maxeo/3dprint-supporto-telefono/originale/foto_5.jpg

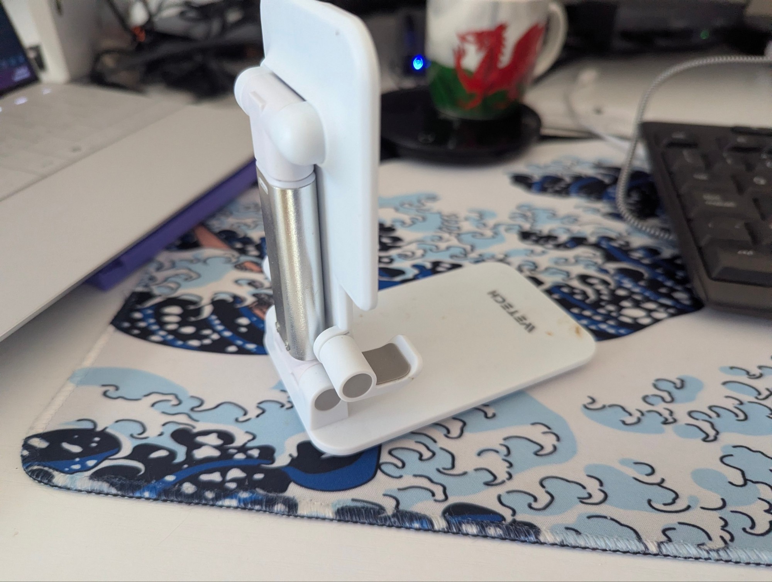
originale/foto_5.jpg
