maxeo/3dprint-supporto-telefono/originale/foto_2.jpg

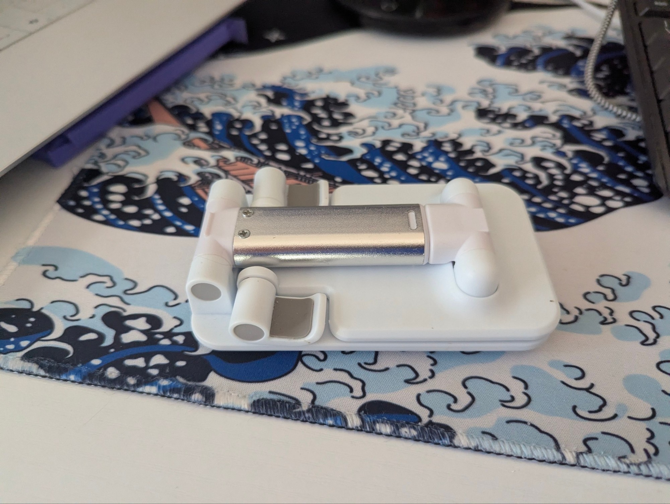
originale/foto_2.jpg
