maxeo/3dprint-supporto-telefono/blender/homescreen.webp

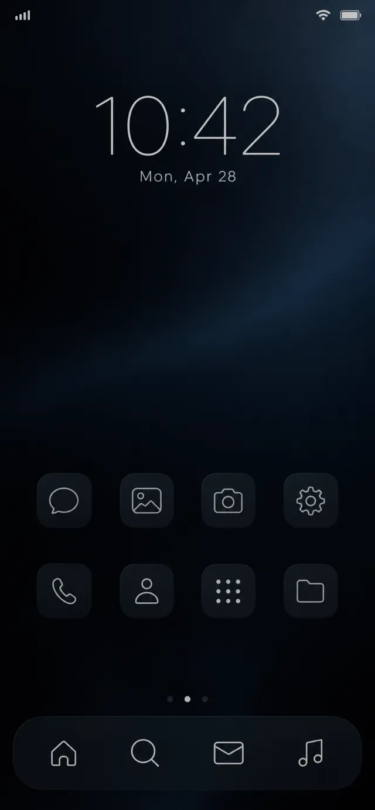
blender/homescreen.webp
