maxeo/3dprint-supporto-telefono/originale/foto_1.jpg

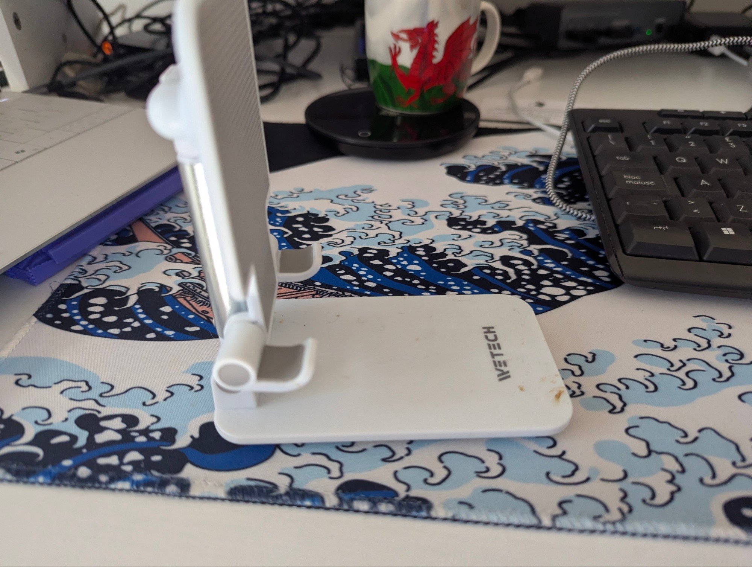
originale/foto_1.jpg
