maxeo/3dprint-supporto-telefono/originale/foto_3.jpg

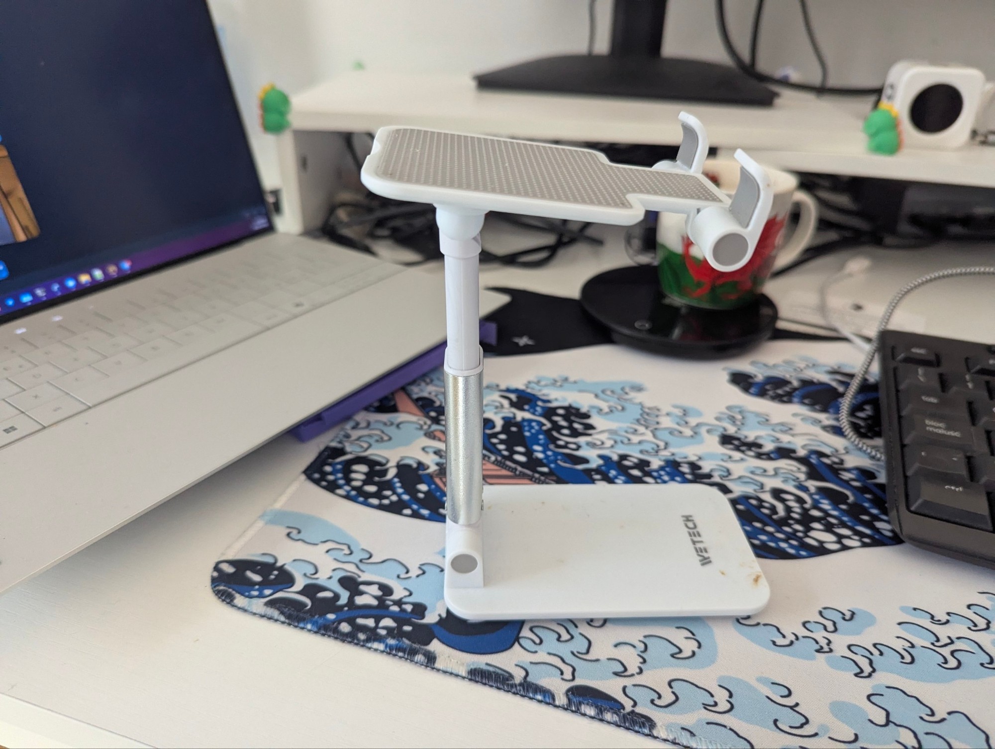
originale/foto_3.jpg
