maxeo/3dprint-supporto-telefono/originale/foto_4.jpg

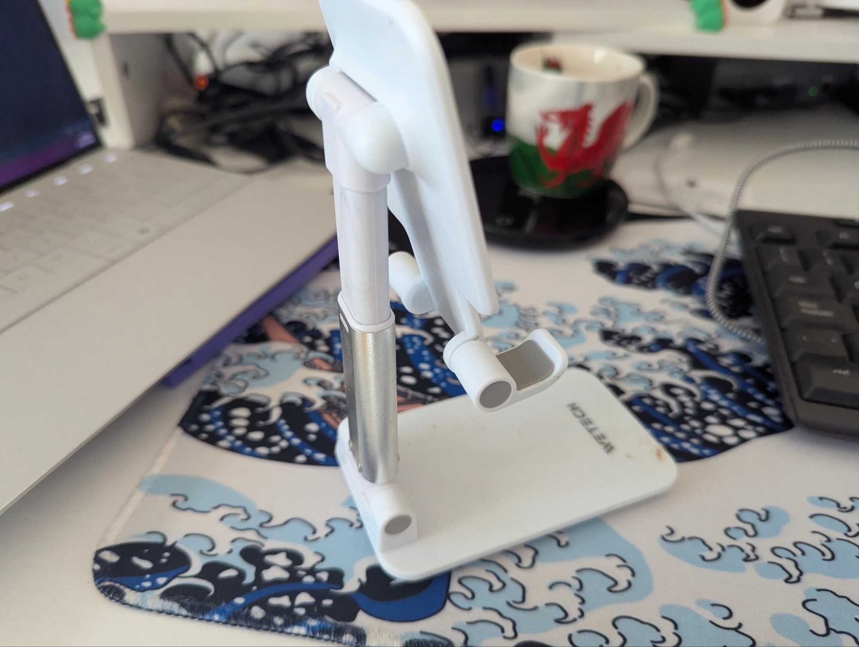
originale/foto_4.jpg
