maxeo/3dprint-supporto-telefono/originale/foto_6.jpg

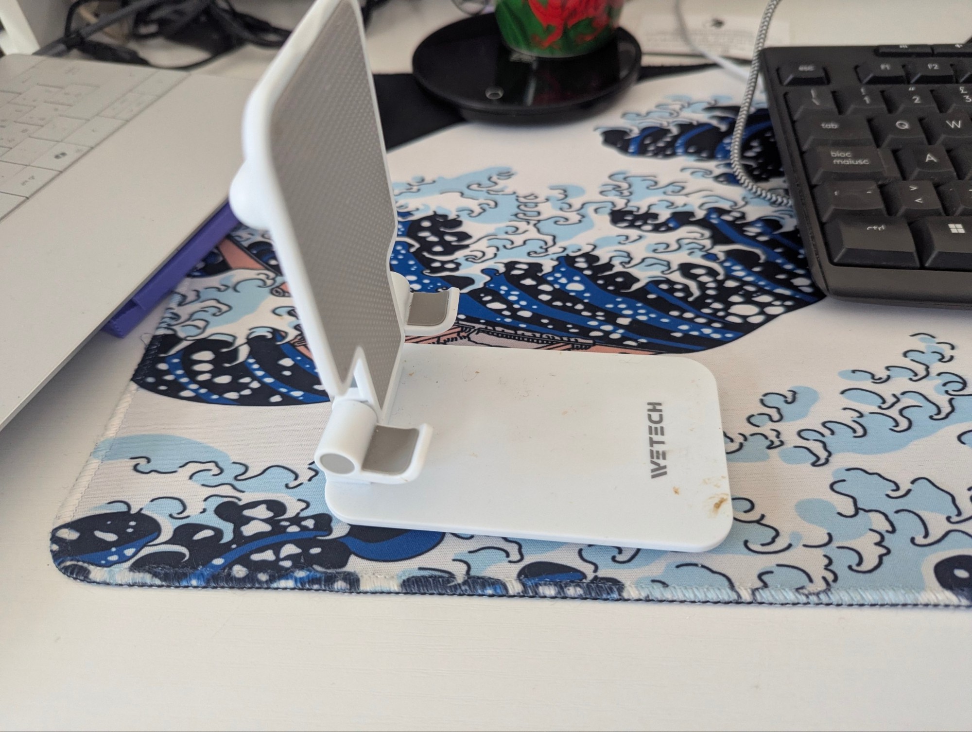
originale/foto_6.jpg
