maxeo/3dprint-supporto-telefono/stl/P05_Appoggio.stl

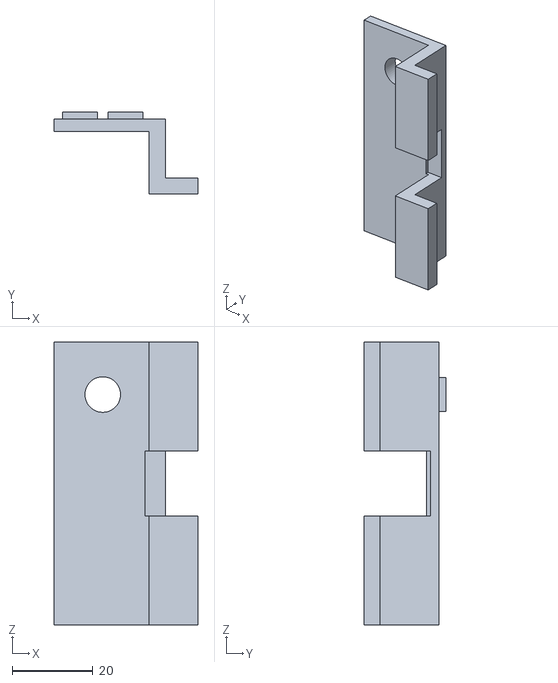
[picture p8: CAD file, 2026-11-01]
stl/P05_Appoggio.stl
35.5 x 20.3 x 70.0
