maxeo/3dprint-supporto-telefono/stl/prove/P10_Pomello_Appoggio_Passante.stl

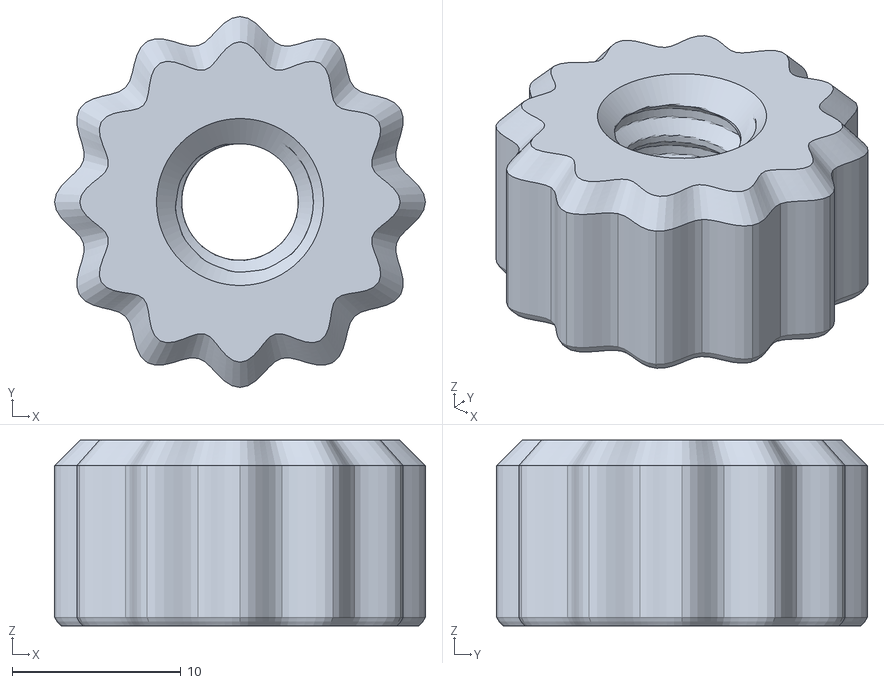
[picture p9: CAD file, 2026-11-01]
stl/prove/P10_Pomello_Appoggio_Passante.stl
22.0 x 22.0 x 11.0
