maxeo/3dprint-supporto-telefono/stl/P02_Guaina.stl

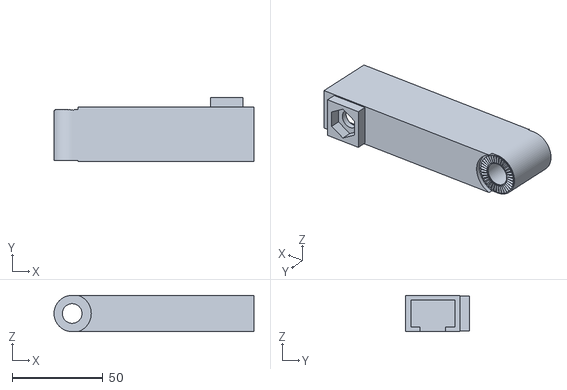
[picture p10: CAD file, 2026-11-01]
stl/P02_Guaina.stl
110.0 x 35.0 x 20.0
