maxeo/3dprint-supporto-telefono/stl/P14_Rondella_Dentata.stl

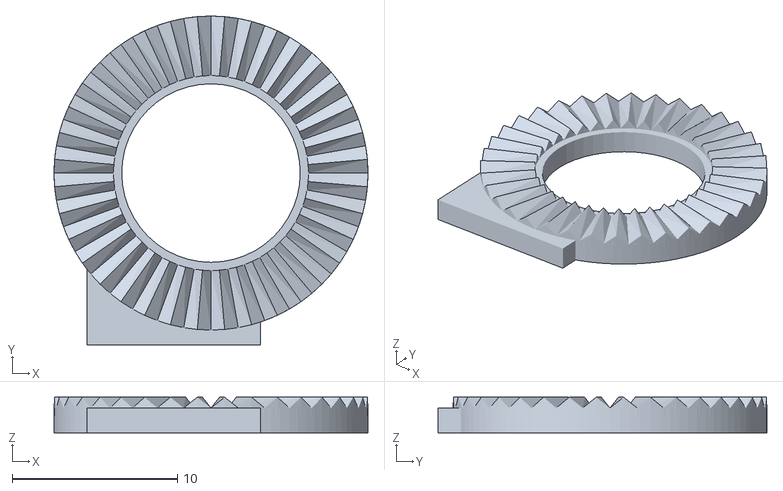
[picture p11: CAD file, 2026-11-01]
stl/P14_Rondella_Dentata.stl
19.0 x 19.9 x 2.15
