maxeo/3dprint-supporto-telefono/stl/P13_Galletto.stl

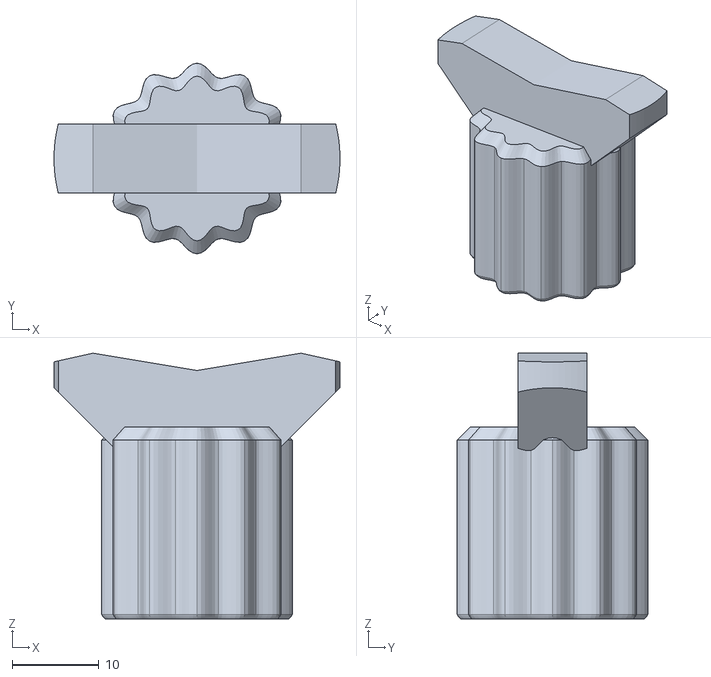
[picture p12: CAD file, 2026-11-01]
stl/P13_Galletto.stl
33.0 x 22.0 x 30.6
