maxeo/3dprint-supporto-telefono/stl/P10_Pomello_Appoggio.stl

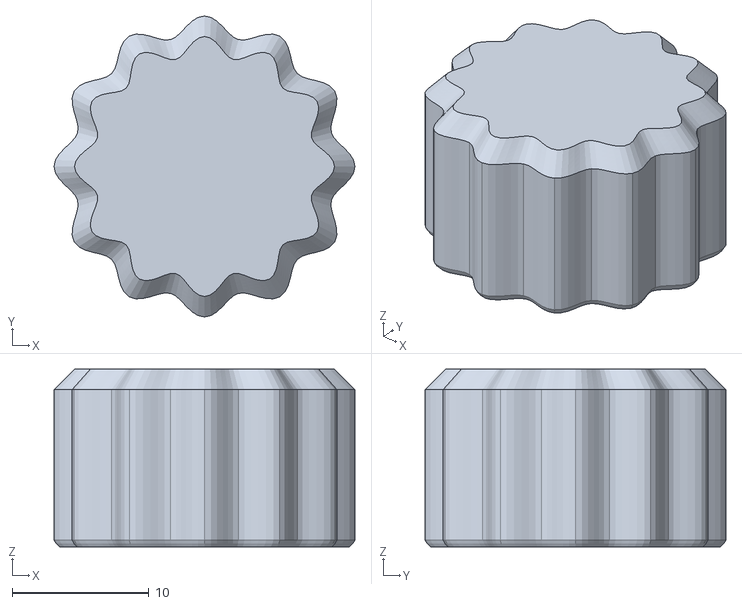
[picture p13: CAD file, 2026-11-01]
stl/P10_Pomello_Appoggio.stl
22.0 x 22.0 x 13.0
