maxeo/3dprint-supporto-telefono/stl/P06_Pomello.stl

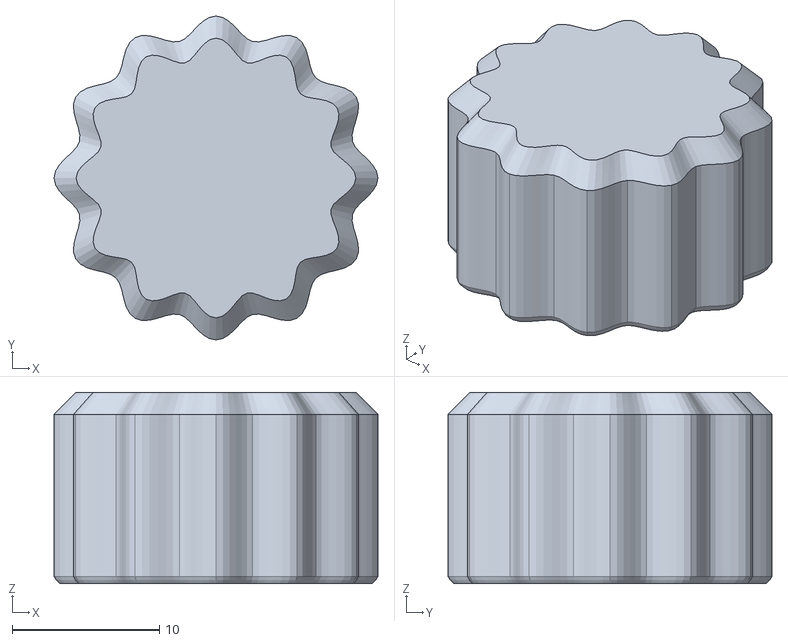
[picture p14: CAD file, 2026-11-01]
stl/P06_Pomello.stl
22.0 x 22.0 x 13.0
