maxeo/3dprint-supporto-telefono/stl/P04_Piatto.stl

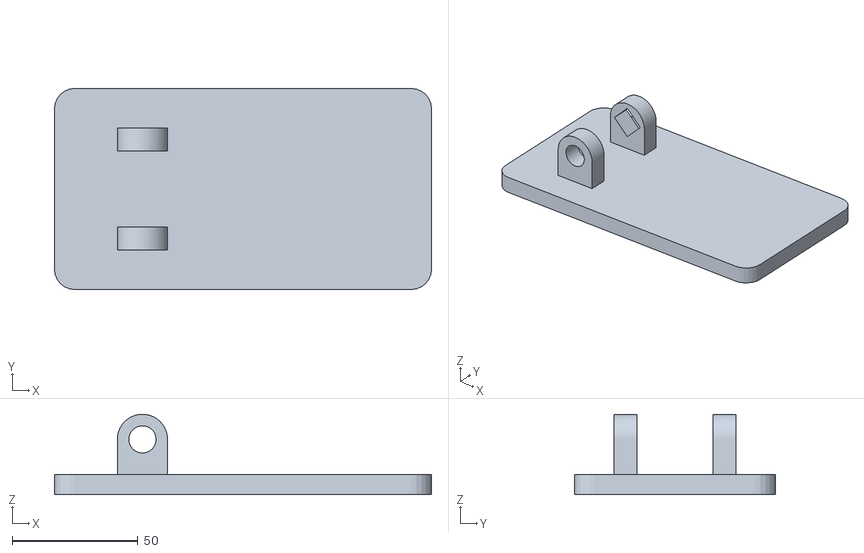
[picture p15: CAD file, 2026-10-31]
stl/P04_Piatto.stl
150.0 x 80.0 x 32.0
