maxeo/3dprint-supporto-telefono/stl/P12_Dado_Morsa.stl

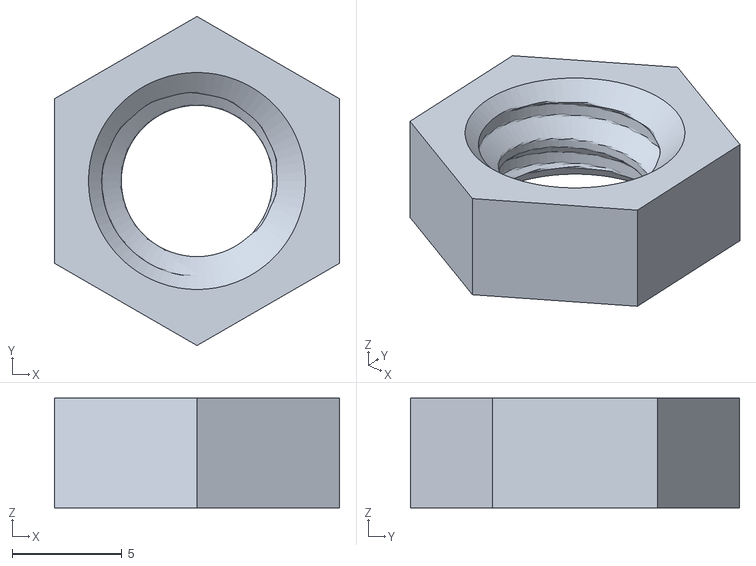
[picture p16: CAD file, 2026-10-31]
stl/P12_Dado_Morsa.stl
13.0 x 15.0 x 5.00
