maxeo/3dprint-supporto-telefono/stl/P03_Slitta.stl

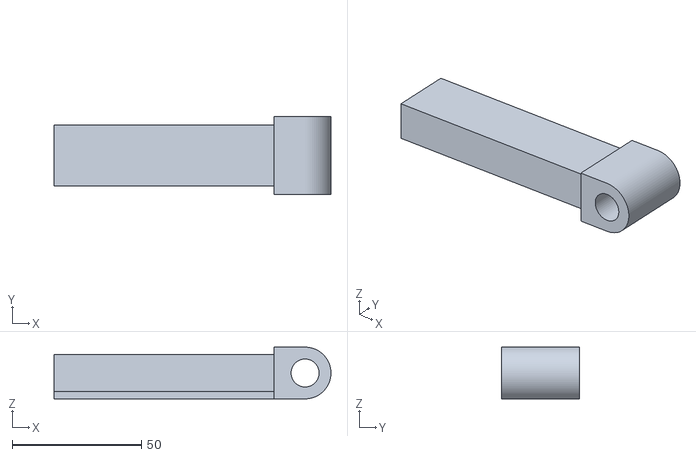
[picture p17: CAD file, 2026-10-31]
stl/P03_Slitta.stl
107.0 x 30.0 x 20.0
