maxeo/3dprint-supporto-telefono/stl/P08_Vite_Cerniera.stl

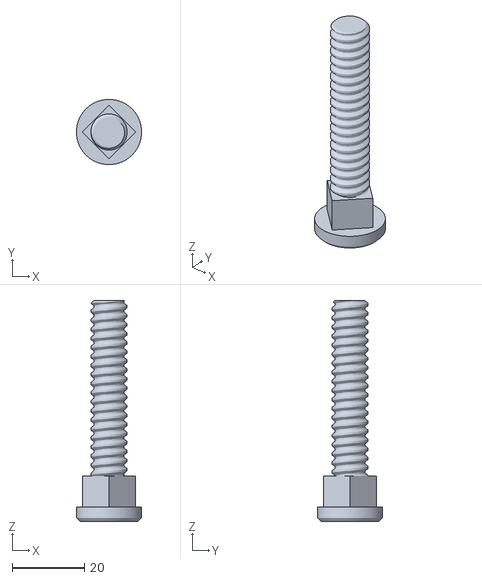
[picture p18: CAD file, 2026-10-31]
stl/P08_Vite_Cerniera.stl
18.0 x 18.0 x 61.0
