maxeo/3dprint-supporto-telefono/stl/P07_Prolunga.stl

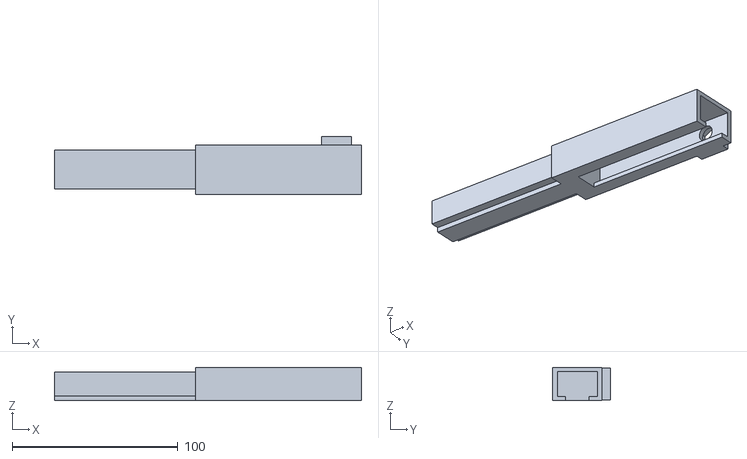
[picture p19: CAD file, 2026-10-31]
stl/P07_Prolunga.stl
185.0 x 35.0 x 20.0
