maxeo/3dprint-supporto-telefono/stl/P09_Vite_Appoggio.stl

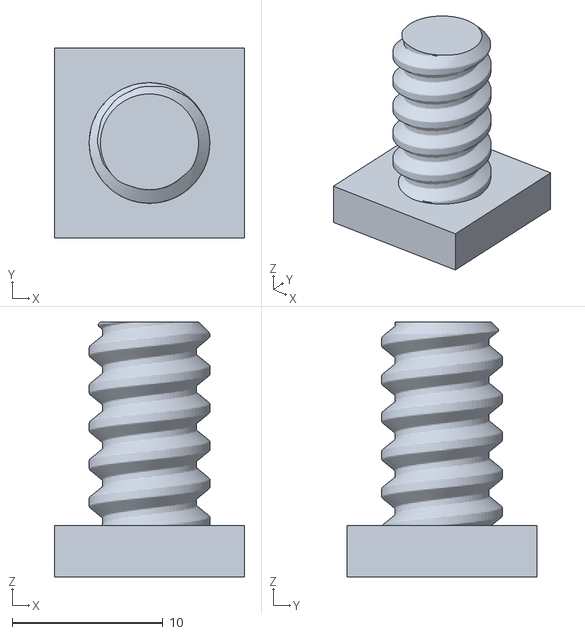
[picture p20: CAD file, 2026-10-31]
stl/P09_Vite_Appoggio.stl
12.6 x 12.6 x 16.9
