maxeo/3dprint-supporto-telefono/stl/P01_Base.stl

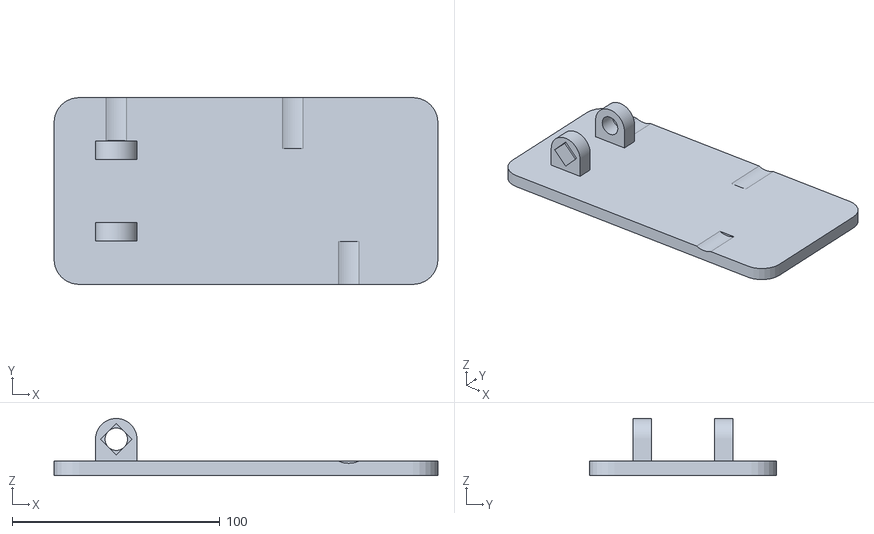
[picture p21: CAD file, 2026-10-31]
stl/P01_Base.stl
185.0 x 90.0 x 27.5
