maxeo/3dprint-supporto-telefono/stl/P11_Pomello_Morsa.stl

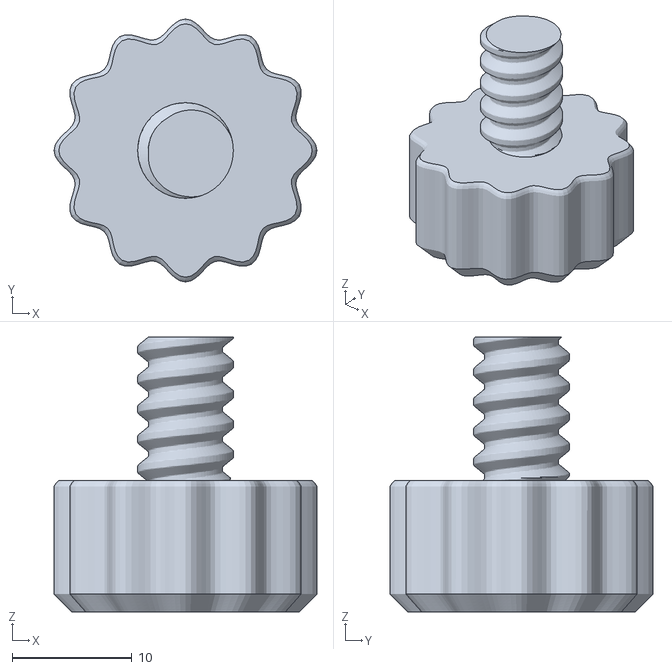
[picture p22: CAD file, 2026-10-31]
stl/P11_Pomello_Morsa.stl
22.0 x 22.0 x 23.0
