maxeo/3dprint-supporto-telefono/(list of files, cad)

Other CAD files:
stl/prove/P06_Pomello_Passante.stl
blender/Supporto_Telefono.blend
blender/Supporto_Telefono_alternative.blend
