maxeo/3dprint-supporto-telefono/(commit log)

2026-10-31 Creato supporto telefono pieghevole stampabile
    - Aggiunti base, braccio telescopico, piatto, appoggio e pomelli
    - Cerniere a frizione con viti M4 e pomelli zigrinati
    - Aggiunto script Blender parametrico con controlli di interferenza
    - Aggiunta guida HTML di stampa e montaggio
    [P01_Base.stl, P02_Guaina.stl, P03_Slitta.stl, P04_Piatto.stl, P05_Appoggio.stl, P06_Pomello.stl, Supporto_Telefono.blend]
2026-10-31 Aggiunti appoggio regolabile e prolunghe impilabili
    - Appoggio che scorre su una guida a T nel piatto, bloccato da pomello
    - Aggiunta prolunga P07 con barra e morsa a pomello, impilabile
    - Nervatura sulle barre per stampare prolunghe e slitta senza supporti
    - Viteria ridotta alla sola M4, base allungata a 185 mm
    - Controlli di interferenza anche con due prolunghe
    - Aggiornati guida e README
    [P01_Base.stl, P02_Guaina.stl, P03_Slitta.stl, P04_Piatto.stl, P05_Appoggio.stl, P07_Prolunga.stl, Supporto_Telefono.blend]
2026-10-31 Aggiunto selettore delle prolunghe nella guida
    - La guida mostra da 0 a 3 prolunghe, di solito 1
    - Vista, passaggi, giunti e lista di stampa seguono la scelta
    - Le viti nella guida hanno testa e dado e restano nei pezzi
    - Posa della scena con 3 prolunghe, misure delle viti nel json
    [Supporto_Telefono.blend]
2026-10-31 Sostituita la viteria M4 con viti e dadi stampati
    - Aggiunte viti di cerniera Ø10 con collo quadro e testa tonda
    - Aggiunti vite a testa quadra e pomello filettato per l'appoggio
    - Morse con pomello e vite in un pezzo, dado esagonale stampato
    - Pomelli delle cerniere con madrevite cieca, filetto passo 2,5
    - Adattati fori, sedi, guida a T, scanalature e incavi della base
    - Filetti in fase nella scena: nessuna interferenza nelle tre pose
    - Aggiornati guida (14 pezzi, senza viteria da comprare) e README
    [P01_Base.stl, P02_Guaina.stl, P03_Slitta.stl, P04_Piatto.stl, P05_Appoggio.stl, P06_Pomello.stl, P07_Prolunga.stl, P08_Vite_Cerniera.stl]
2026-10-31 Aggiunto il link alla guida online nel README
2026-11-01 Aggiunti denti alla cerniera bassa, telefono e cavo
    - Aggiunta rondella dentata P14 e denti radiali sulla guaina P02
    - Aumentato il margine della madrevite nei pomelli P06 e P10
    - Aggiunto galletto P13 come alternativa per la cerniera bassa
    - Aggiunti pomelli passanti di prova in stl/prove
    - Aggiunto telefono con homescreen, tasti e presa USB-C
    - Aggiunti cavo e spina che passano dall'asola dell'appoggio
    - Divisi i passi finali della guida: cavo, poi telefono e regolazioni
    [P02_Guaina.stl, P06_Pomello.stl, P06_Pomello_Passante.stl, P10_Pomello_Appoggio.stl, P10_Pomello_Appoggio_Passante.stl, P13_Galletto.stl, P14_Rondella_Dentata.stl, Supporto_Telefono.blend]
2026-11-01 Aperta la sponda dell'appoggio sopra l'asola del cavo
    - Tagliata la sponda di P05 fino in cima, larga quanto l'asola (16 mm)
    - Il cavo USB-C ora si infila e si sfila dall'alto
    - Aggiornati i testi della guida e il README
    [P05_Appoggio.stl, Supporto_Telefono.blend]
